Rich5252/HP_Server_PSU_DPS1200FB_HSTNS-FD19_Controller/Docs + Photos/20240201_133005.jpg

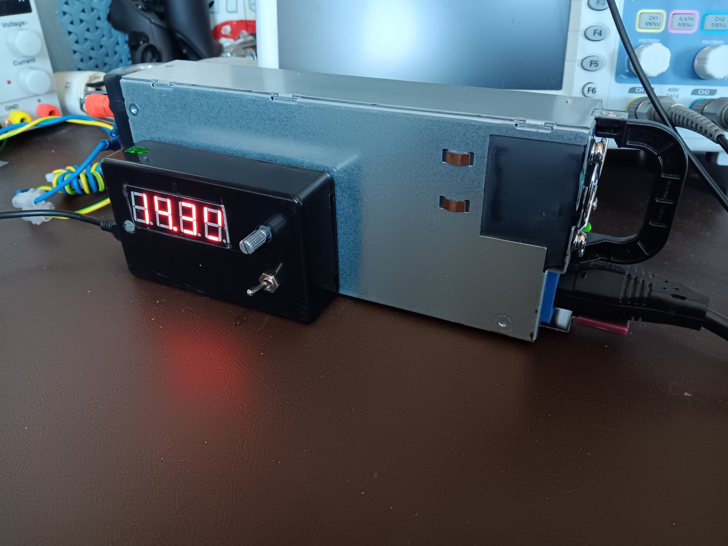
Docs + Photos/20240201_133005.jpg
