Rich5252/HP_Server_PSU_DPS1200FB_HSTNS-FD19_Controller/Docs + Photos/20240124_194222 PSU details.jpg

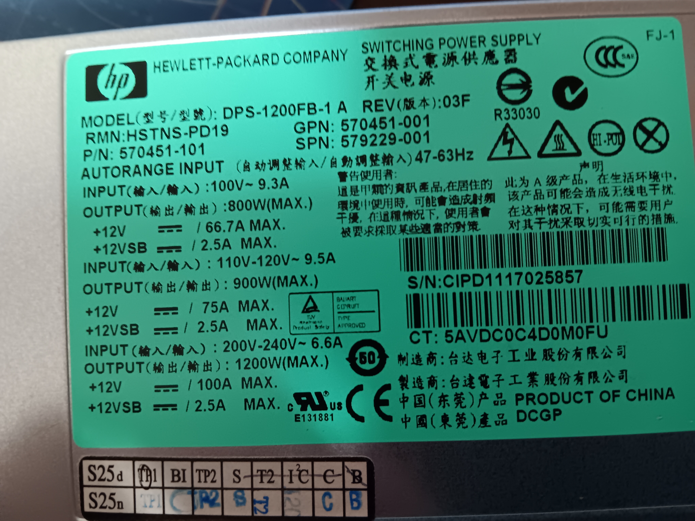
Docs + Photos/20240124_194222 PSU details.jpg
