Rich5252/HP_Server_PSU_DPS1200FB_HSTNS-FD19_Controller/Docs + Photos/DPS1200 Controller Circuit.png

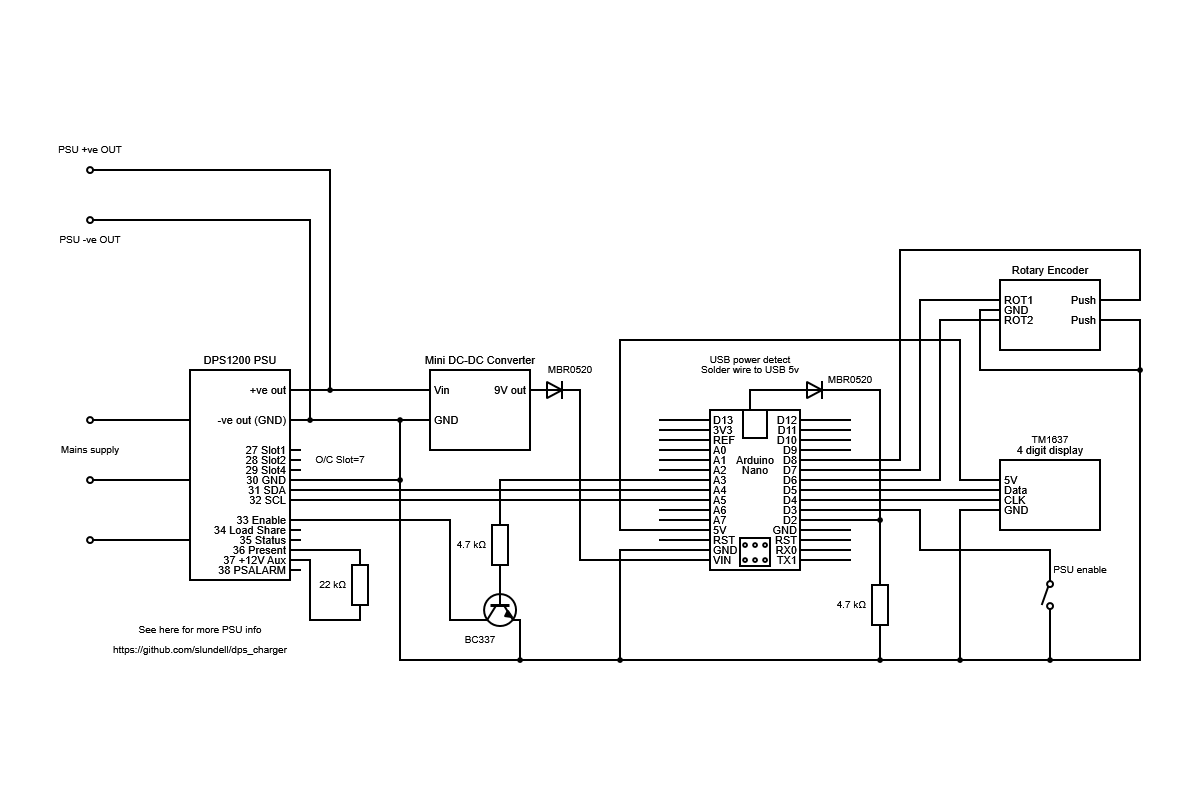
Docs + Photos/DPS1200 Controller Circuit.png
